mashrursaademad/8051-scientific-calculator/(list of files, drawings)

Other design files:
proteus/Calculator_v1.1.pdsprj
